ferramr/Proyecto-Capstone/PROYECTO CAPSTONE.pptx

## PROYECTO CAPSTONE

Marzo, 2022

## PARTICIPANTES

Eduardo Rodríguez Martínez
Fernando Ramírez Rojas

## LABORATORIO REMOTO PARA CURSOS DE FÍSICA BÁSICA

PLANO INCLINADO

## Slide 4

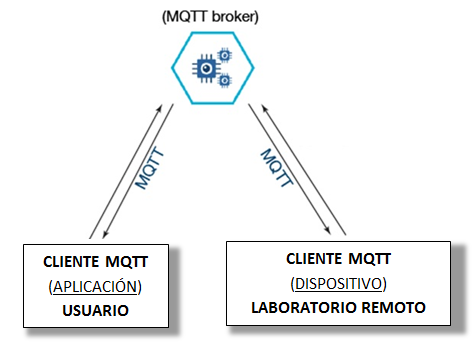
[picture p1: figure]

## Slide 5

## Slide 6

angulo

## Slide 7

inicializa

## Slide 8

angulo cero

## Slide 9

angulo solicitado

## Slide 10

Libera esfera

## Slide 11

finalizado

## Slide 12

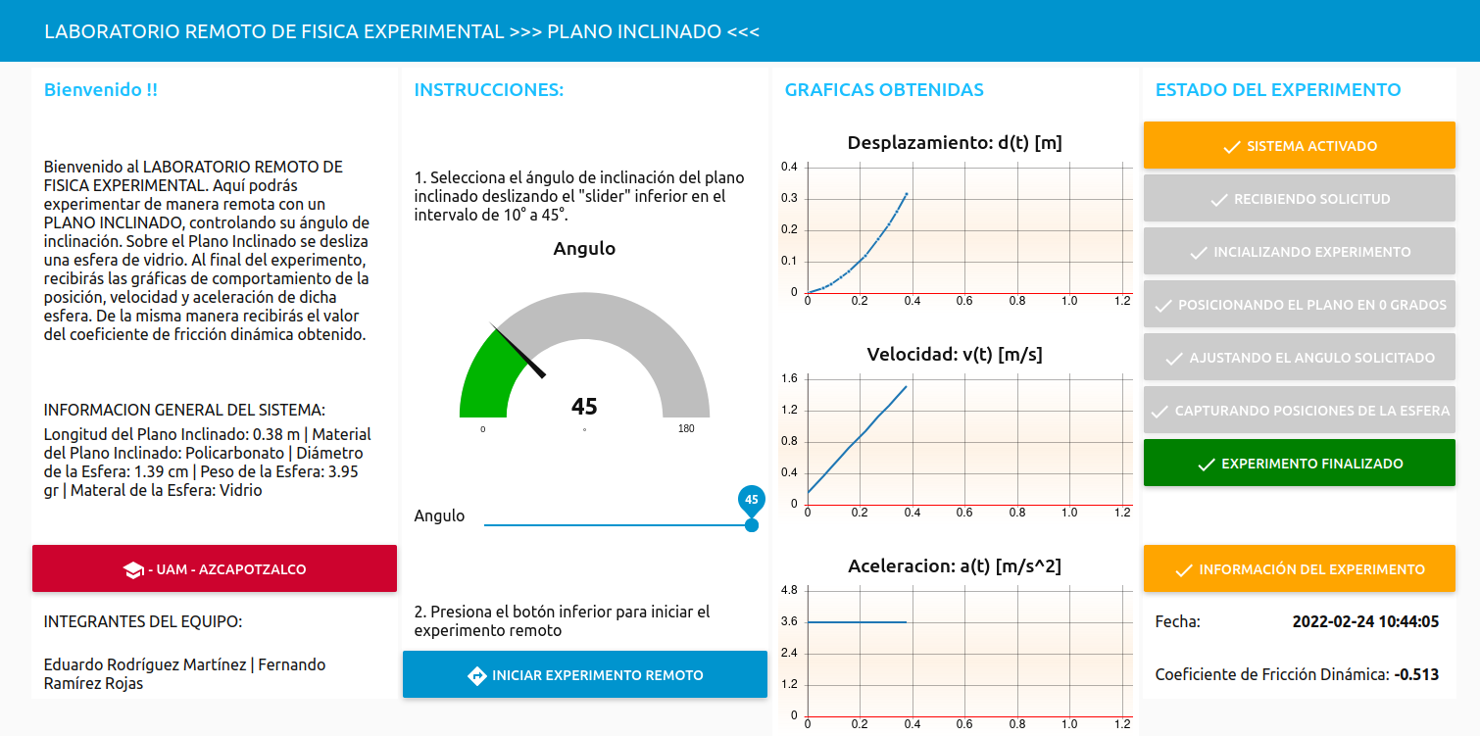
[picture p2: figure]

## Slide 13

## Slide 14

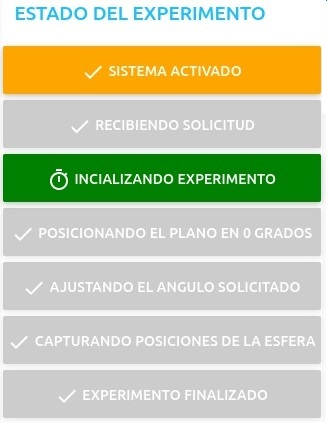
[picture p3: figure]
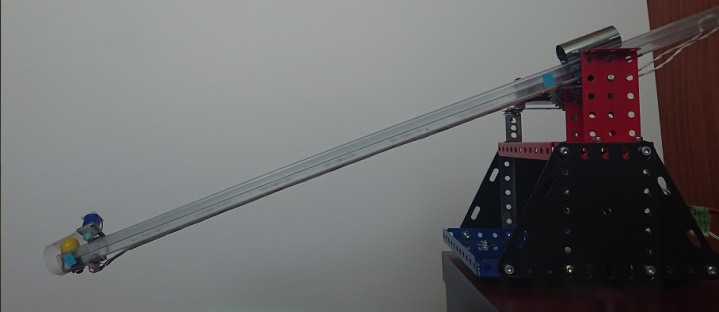
[picture p4: figure]

## Slide 15

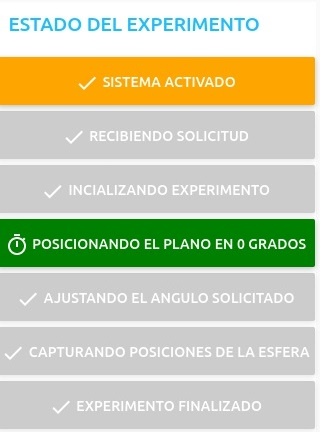
[picture p5: figure]
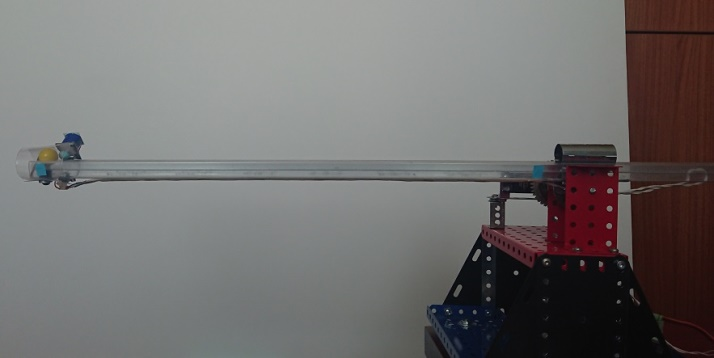
[picture p6: figure]

## Slide 16

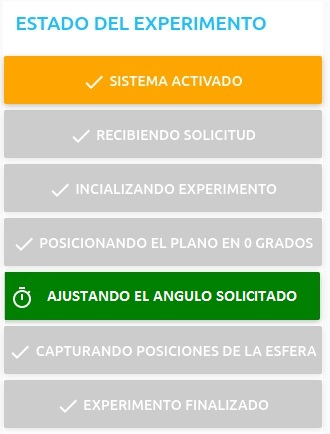
[picture p7: figure]
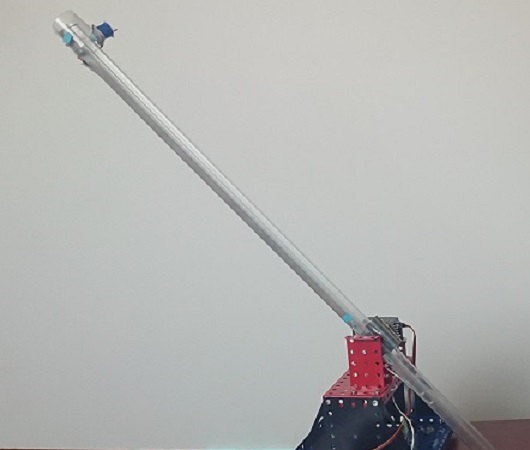
[picture p8: figure]

## Slide 17

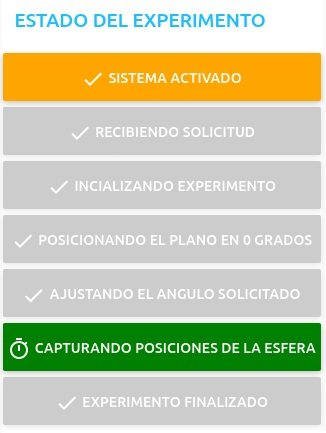
[picture p9: figure]

## Slide 18

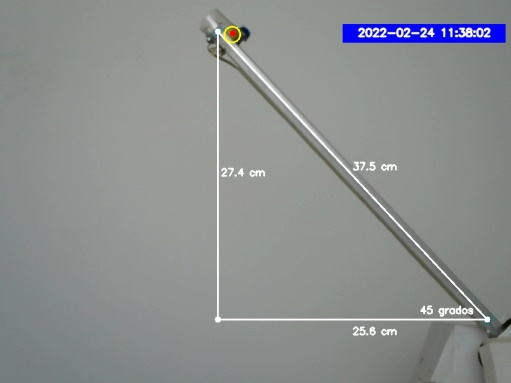
[picture p10: figure]
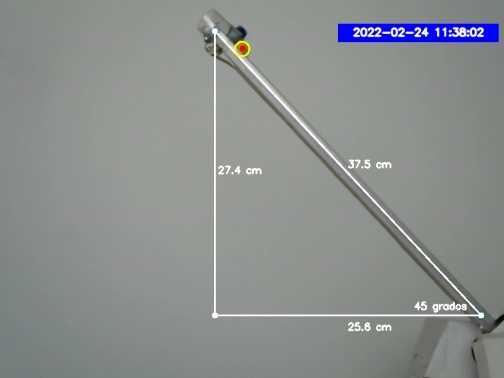
[picture p11: figure]
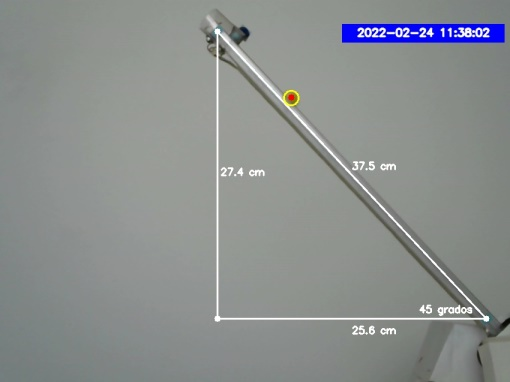
[picture p12: figure]
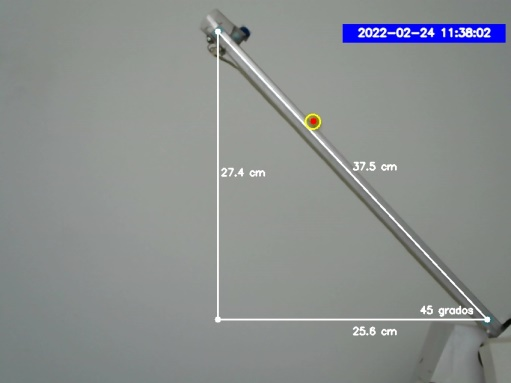
[picture p13: figure]
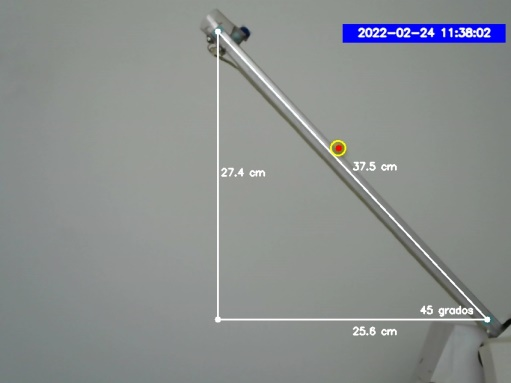
[picture p14: figure]
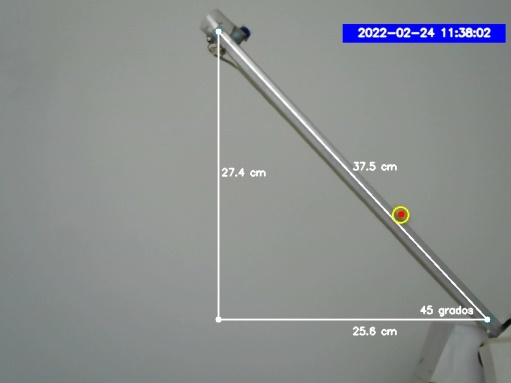
[picture p15: figure]
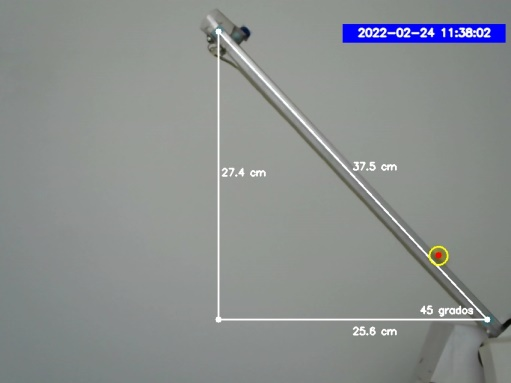
[picture p16: figure]

## Slide 19

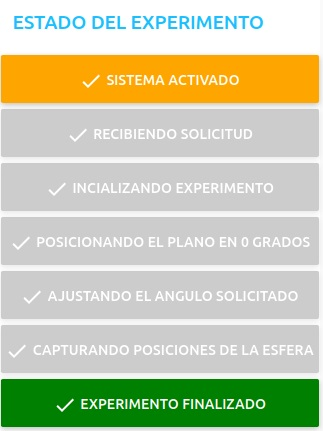
[picture p17: figure]
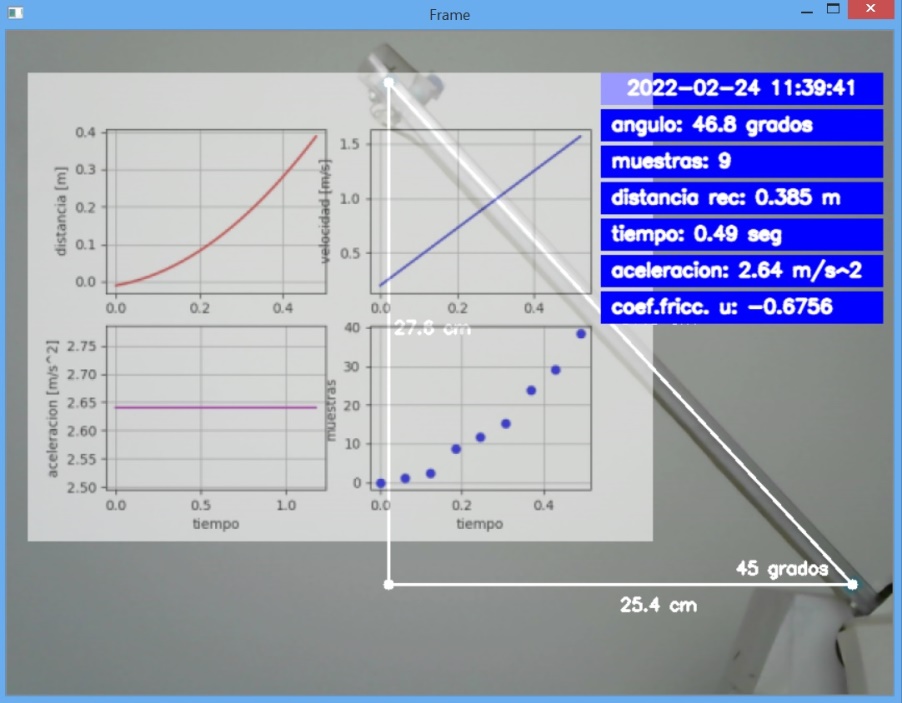
[picture p18: figure]

## Slide 20

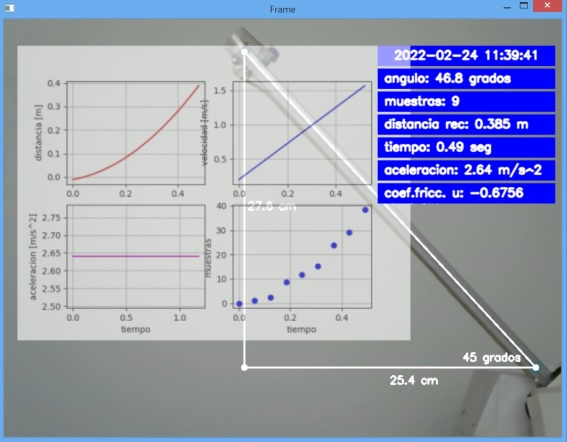
[picture p19: figure]

## Slide 21

## Slide 22

Gracias !

## Slide 23

## Slide 24

## Slide 25

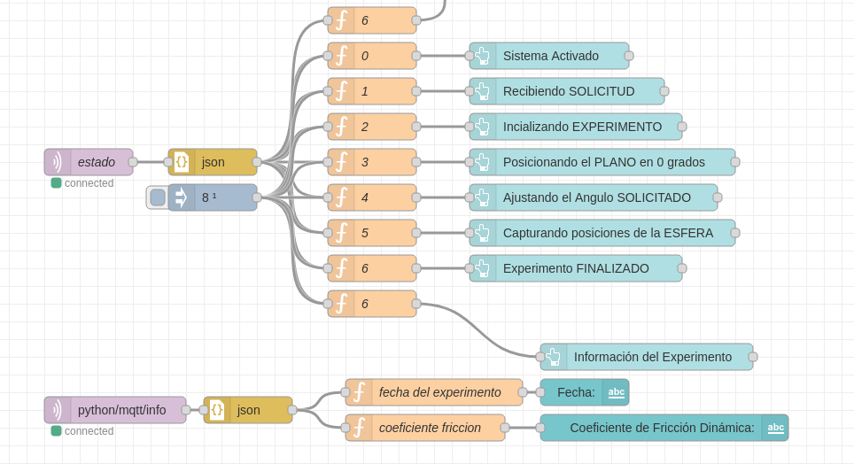
[picture p20: figure]

## Slide 26

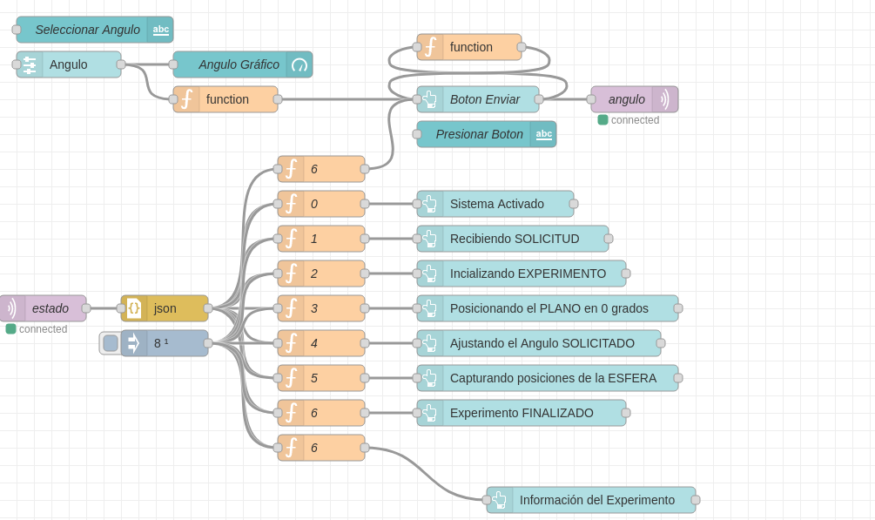
[picture p21: figure]

## Slide 27

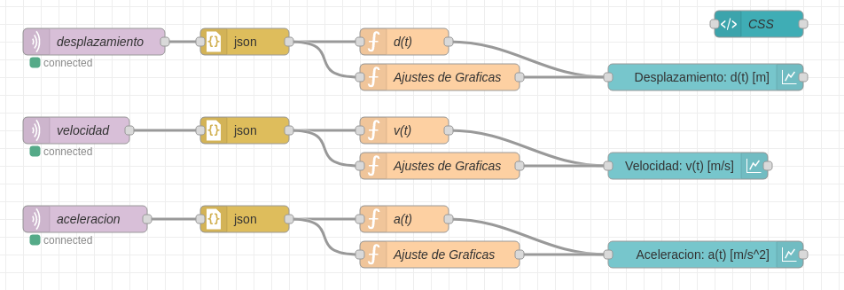
[picture p22: figure]

## Slide 28

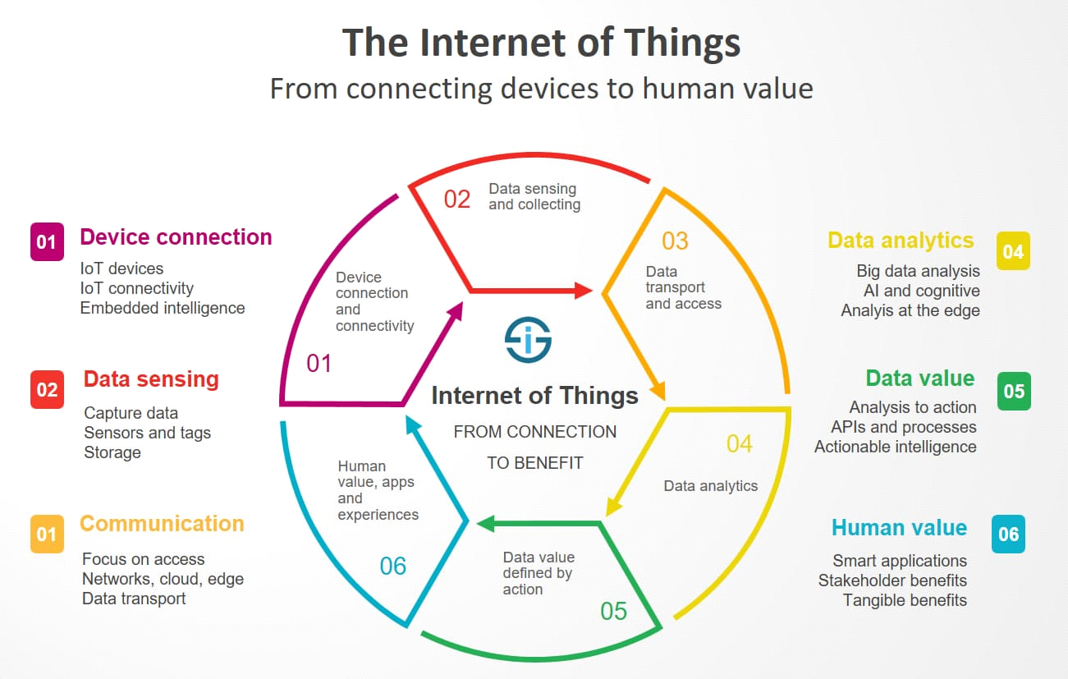
[picture p23: figure]
