ferramr/Proyecto-Capstone/Codigo Python/grafica_0.jpg

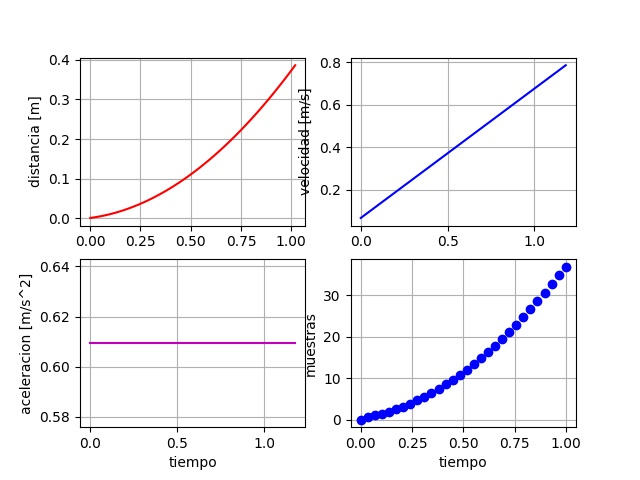
Codigo Python/grafica_0.jpg
