ferramr/Proyecto-Capstone/(commit log)

2022-03-05 Codigo Arduino
2022-03-05 Codigo de Arduino
